orhosko/tiny-ntt/rtl/inverse_twiddle_rom.v

`timescale 1ns / 1ps

module inverse_twiddle_rom #(
    parameter WIDTH      = 32,
    parameter ADDR_WIDTH = 8
) (
    input  wire [ADDR_WIDTH-1:0] addr,
    output reg  [WIDTH-1:0]      twiddle
);

  always @(*) begin
    case (addr)
      8'd0: twiddle = 32'd1;
      8'd1: twiddle = 32'd4231948;
      8'd2: twiddle = 32'd5344437;
      8'd3: twiddle = 32'd8378664;
      8'd4: twiddle = 32'd6444618;
      8'd5: twiddle = 32'd508145;
      8'd6: twiddle = 32'd3073009;
      8'd7: twiddle = 32'd7767179;
      8'd8: twiddle = 32'd5926434;
      8'd9: twiddle = 32'd1623354;
      8'd10: twiddle = 32'd2312838;
      8'd11: twiddle = 32'd2678278;
      8'd12: twiddle = 32'd3602218;
      8'd13: twiddle = 32'd1716814;
      8'd14: twiddle = 32'd6392603;
      8'd15: twiddle = 32'd4146264;
      8'd16: twiddle = 32'd7375178;
      8'd17: twiddle = 32'd6764887;
      8'd18: twiddle = 32'd5801164;
      8'd19: twiddle = 32'd2296397;
      8'd20: twiddle = 32'd7823561;
      8'd21: twiddle = 32'd4385746;
      8'd22: twiddle = 32'd5396636;
      8'd23: twiddle = 32'd4040196;
      8'd24: twiddle = 32'd5010068;
      8'd25: twiddle = 32'd1187885;
      8'd26: twiddle = 32'd7369194;
      8'd27: twiddle = 32'd27812;
      8'd28: twiddle = 32'd4361428;
      8'd29: twiddle = 32'd4405932;
      8'd30: twiddle = 32'd1528066;
      8'd31: twiddle = 32'd5737437;
      8'd32: twiddle = 32'd3145678;
      8'd33: twiddle = 32'd3033742;
      8'd34: twiddle = 32'd7153756;
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
      8'd231: twiddle = 32'd89301;
      8'd232: twiddle = 32'd2283733;
      8'd233: twiddle = 32'd7200804;
      8'd234: twiddle = 32'd2683270;
      8'd235: twiddle = 32'd2455377;
      8'd236: twiddle = 32'd6279007;
      8'd237: twiddle = 32'd6022044;
      8'd238: twiddle = 32'd3258457;
      8'd239: twiddle = 32'd4768667;
      8'd240: twiddle = 32'd2682288;
      8'd241: twiddle = 32'd3369273;
      8'd242: twiddle = 32'd4182915;
      8'd243: twiddle = 32'd7743490;
      8'd244: twiddle = 32'd1858416;
      8'd245: twiddle = 32'd214880;
      8'd246: twiddle = 32'd1937570;
      8'd247: twiddle = 32'd2178965;
      8'd248: twiddle = 32'd434125;
      8'd249: twiddle = 32'd5889092;
      8'd250: twiddle = 32'd1744507;
      8'd251: twiddle = 32'd1596822;
      8'd252: twiddle = 32'd1095468;
      8'd253: twiddle = 32'd731434;
      8'd254: twiddle = 32'd8210729;
      8'd255: twiddle = 32'd7140506;
      default: twiddle = 32'd0;
    endcase
  end

endmodule
