orhosko/tiny-ntt/rtl/twiddle_rom.v

`timescale 1ns / 1ps

module twiddle_rom #(
    parameter N          = 4096,
    parameter WIDTH      = 32,
    parameter ADDR_WIDTH = $clog2(N)
) (
    input  wire [ADDR_WIDTH-1:0] addr,
    output reg  [WIDTH-1:0]      twiddle
);

  always @(*) begin
    case (addr)
      8'd0: twiddle = 32'd1;
      8'd1: twiddle = 32'd1239911;
      8'd2: twiddle = 32'd169688;
      8'd3: twiddle = 32'd7648983;
      8'd4: twiddle = 32'd7284949;
      8'd5: twiddle = 32'd6783595;
      8'd6: twiddle = 32'd6635910;
      8'd7: twiddle = 32'd2491325;
      8'd8: twiddle = 32'd7946292;
      8'd9: twiddle = 32'd6201452;
      8'd10: twiddle = 32'd6442847;
      8'd11: twiddle = 32'd8165537;
      8'd12: twiddle = 32'd6522001;
      8'd13: twiddle = 32'd636927;
      8'd14: twiddle = 32'd4197502;
      8'd15: twiddle = 32'd5011144;
      8'd16: twiddle = 32'd5698129;
      8'd17: twiddle = 32'd3611750;
      8'd18: twiddle = 32'd5121960;
      8'd19: twiddle = 32'd2358373;
      8'd20: twiddle = 32'd2101410;
      8'd21: twiddle = 32'd5925040;
      8'd22: twiddle = 32'd5697147;
      8'd23: twiddle = 32'd1179613;
      8'd24: twiddle = 32'd6096684;
      8'd25: twiddle = 32'd8291116;
      8'd26: twiddle = 32'd5157610;
      8'd27: twiddle = 32'd6866265;
      8'd28: twiddle = 32'd817536;
      8'd29: twiddle = 32'd1780227;
      8'd30: twiddle = 32'd5006167;
      8'd31: twiddle = 32'd2647994;
      8'd32: twiddle = 32'd5496691;
      8'd33: twiddle = 32'd8368000;
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
      8'd231: twiddle = 32'd7192532;
      8'd232: twiddle = 32'd3370349;
      8'd233: twiddle = 32'd4340221;
      8'd234: twiddle = 32'd2983781;
      8'd235: twiddle = 32'd3994671;
      8'd236: twiddle = 32'd556856;
      8'd237: twiddle = 32'd6084020;
      8'd238: twiddle = 32'd2579253;
      8'd239: twiddle = 32'd1615530;
      8'd240: twiddle = 32'd1005239;
      8'd241: twiddle = 32'd4234153;
      8'd242: twiddle = 32'd1987814;
      8'd243: twiddle = 32'd6663603;
      8'd244: twiddle = 32'd4778199;
      8'd245: twiddle = 32'd5702139;
      8'd246: twiddle = 32'd6067579;
      8'd247: twiddle = 32'd6757063;
      8'd248: twiddle = 32'd2453983;
      8'd249: twiddle = 32'd613238;
      8'd250: twiddle = 32'd5307408;
      8'd251: twiddle = 32'd7872272;
      8'd252: twiddle = 32'd1935799;
      8'd253: twiddle = 32'd1753;
      8'd254: twiddle = 32'd3035980;
      8'd255: twiddle = 32'd4148469;
      default: twiddle = 32'd0;
    endcase
  end

endmodule
