orhosko/tiny-ntt/(commit log)

2026-02-16 Bugfix & new top level module
    [ntt_forward.sv, ntt_inverse.sv, ntt_poly_mult.sv]
2026-02-17 Fix priority issue of memory writes
    [ntt_forward.sv, ntt_inverse.sv, ntt_poly_mult.sv]
2026-03-20 Verilator fixes & add debug signals
    [ntt_forward.sv, ntt_inverse.sv, ntt_poly_mult.sv]
2026-04-26 Remove reset from the internal arithmetic pipeline regs in mod_mult
    [mod_mult.v]
2026-04-27 Add pipeline stage to barrett mult
2026-05-01 Coeff bank BRAM fix
    [ntt_coeff_bank_single.v]
